heitzalexis/Maze/Rapport Final Projet Arduino - Douzet & Heitz.pdf

# DOUZET Camille HEITZ Alexis

# PROJET D’ARDUINO

# BB-MAZE

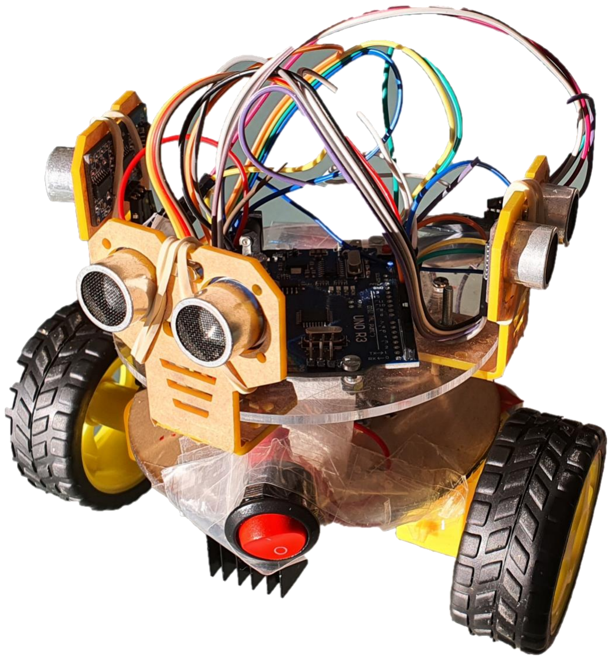
[picture p4: figure]

# Sommaire

## I. Introduction ___________________________________3

II. | Descriptif du projet _____________________________3
| II.1. L’objectif ___________________________________3
| II.2. Le cahier des charges _________________________3
III. | Description du robot et fonctionnement ____________5
| III.1. Mécanique et électronique : structure du robot ____5
| III.2. Le code_____________________________________5
IV. | Le planning ___________________________________7

## V. Synthèse _____________________________________8

| V.1. Ce que ce projet nous a apporté _________________8
| V.2. Ce que nous aurions fait différemment ___________9
VI. | Remerciements ________________________________9

## VII. Conclusions____________________________________9

| VII.1. Ce qui a été fait ______________________________9
| VII.2. Ce qu’il reste à faire___________________________10

## VIII. Bibliographies__________________________________10

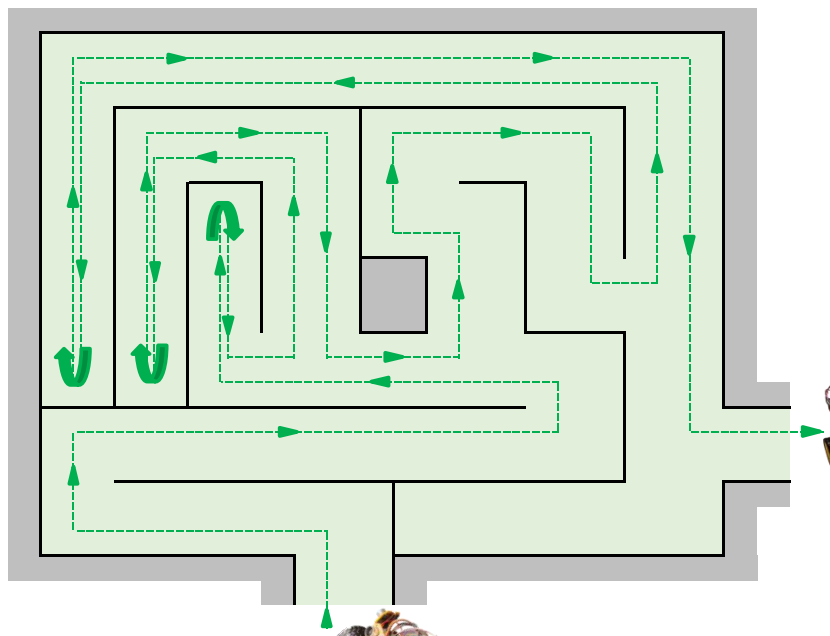
[picture p5: figure]

## I. Introduction

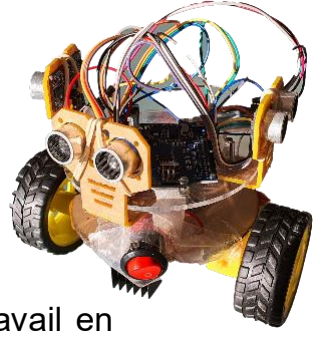
[picture p6: figure]

Le projet Arduino permet d’avoir une idée du métier d’ingénieur et du travail en entreprise. L’objectif est de nous faire travailler en équipe, sur un problème réel, afin de nous familiariser avec la méthodologie projet (Cahier des charges, comptesrendus de réunion, suivi de planning, etc …).

Nous avons appris à gérer les imprévus. Le projet a été réalisé avec un budget limité et nous a permis d’utiliser les connaissances acquises en cours, comme par exemple, l’utilisation des moteurs ou du module Bluetooth.

II. | Descriptif du projet II.1. L’objectif
| L’objectif de ce projet est de concevoir un robot motorisé, nommé BB-MAZE, fonctionnant avec la carte Arduino. BB-MAZE doit arriver à sortir d’un labyrinthe à l’aide de capteurs et d’une motorisation directionnelle. Nous partons ici du principe que les labyrinthes utilisés dans ce projet, sont définis par des murs tous reliés entre eux (C’est-à-dire connexes) et que l’on peut se rendre à n’importe quel point de ce mur, sans faire de saut. BB-MAZE est ainsi capable de se rendre à la sortie, où qu’elle soit dans le labyrinthe, en suivant, par exemple, systématiquement le mur de gauche.
| II.2 Le cahier des charges
1. Equipe projet :
| • DOUZET Camille • HEITZ Alexis
2. Environnement :
| Ce projet est réalisé dans le cadre du cours d’électronique de Peip2 de Polytech Sophia.
3. Contraintes :
| • La taille de BB-MAZE doit correspondre aux exigences vues en cours : Trop grand, il sera difficile à manipuler, encore plus dans un labyrinthe. Notamment pour réaliser les demi-tours. • Le labyrinthe comporte un point de départ et un point d’arrivée distincts. La taille des couloirs du labyrinthe doit être sensiblement supérieure à celle du robot. • BB-MAZE doit réussir à se déplacer sans percuter les obstacles. Et il pourra se trouver dans une impasse. BB-MAZE va rencontrer différentes situations qu’il devra analyser en ayant simplement les distances autour de lui. Une impasse est analysée ainsi : je n’ai pas de place, ni à gauche, ni à droite, ni devant. Donc je dois faire demi-tour. • Le robot doit avoir une connexion radiofréquence : Dans notre projet nous avons choisi le Bluetooth.

Commentaire de fin de projet : BB-MAZE devant être autonome, nous ne pouvions pas le contrôler par Bluetooth. Nous avons donc décidé d’utiliser cette connexion afin de nous indiquer ce que le robot analyse.

4. Description du robot :
- BB-MAZE est constitué d’une plaque de plexiglas découpée en forme de disque avec deux roues motrices, et une autre roue folle afin de faciliter ses déplacements dans le labyrinthe. Sa forme ronde permettra d’éviter de s’accrocher sur les murs.
- Les composants électroniques sont directement montés sur la plaque de plexiglas.
- Le robot doit se repérer dans le labyrinthe : Pour cela, il est équipé de 3 modules Sonar HC-SR04 qui donneront la distance à son environnement.
- Les fonctionnalités Bluetooth permettent de rendre compte des actions réalisées par le robot en envoyant une liste de petites phrases (“J’avance”, “Je tourne à gauche”, ...) au fur et à mesure de sa progression.
- Commentaire de fin de projet : Nous avons rajouté une pile 9 V (Voir chapitre III.1.)
5. Caractéristiques :
5.1. Caractéristiques générales :
- La taille de BB-MAZE doit être inférieure à 25 cm².
- Ses mouvements de rotation et de translation sont assurés par deux roues motrices. Pour diriger le robot, on fait tourner les deux roues avec des vitesses de rotation différentes. Pour un demi-tour nous inversons simplement le sens d’une des deux roues.
5.2. Caractéristiques générales :
- Il y a un bouton « Marche / arrêt » pour ne pas être dépendant du Bluetooth.

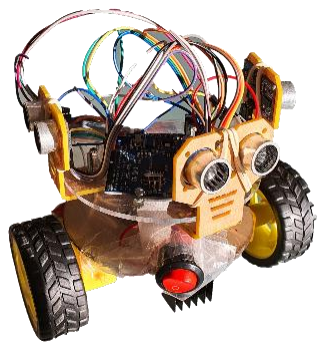
[picture p7: figure]

5.3. Informatique :
- La communication entre BB-MAZE et le téléphone se fait par Bluetooth. Nous utilisons l’application « Bluetooth Electronics » et un téléphone Android qui dispose de cette application.
- La programmation pour la recherche de la sortie du labyrinthe et pour la commande de la motorisation se font avec le logiciel Arduino.
5.4. Electronique :
- Une carte Arduino UNO comme celle utilisée dans les dernières séances avec le robot.
- 3 modules Sonar HC-SR04, pour la mesure de la position du robot dans l’espace (Ici appliqué au labyrinthe).
- Une commande de la motorisation et de la direction des roues.

5.5. Tests de validation :
- La validation se fait si BB-MAZE arrive à sortir du labyrinthe avec succès à plusieurs reprises sans percuter les murs.
Commentaire de fin de projet : Cette validation a été compliquée, car la fonction « Avancer tout droit » rencontrait des difficultés. La motorisation était trop faible, et les défauts du sol bloquaient très souvent les roues.
7. Coûts :

L’université définie le budget pour la réalisation de ce projet. Nous utilisons des composants peu coûteux. Ils pourront être réutilisés pour mener à bien d’autres futurs projets.

8. Délais :

Le planning du projet est défini séparément sur un Gantt

- Définition du projet : Fin Novembre 2019.
- 1ère phase de développement : Décembre 2019 à mi-Janvier 2020.
- Un premier oral de présentation : Mi-Janvier 2020.
- Fin du développement : Mi-Janvier 2020 à Mi-Mars 2020.
- Un dernier oral de présentation en Mi-Mars 2020.

## III. Description du robot et fonctionnement III.1. Partie mécanique et électronique : structure du robot

La partie mécanique et électronique de BB-MAZE est composée de deux disques en plexiglas qui forment 3 étages.

Sur la partie la plus basse, nous avons fixé les deux moteurs avec chacun une roue motrice. On y trouve également la carte Driver Motor (L298N Double Pont) et la roue folle. Nous avons eu beaucoup de problème pour fiabiliser le fonctionnement de cette motorisation qui s’est avérée trop faible, compte-tenu des imperfections du sol : Les roues se sont régulièrement bloquées.

A l’étage intermédiaire, se trouve l’alimentation (4 piles de 1,5 volts) et l’interrupteur de « Marche / arrêt ». Nous avons ajouté en cours de projet une pile 9 volts, afin de gérer les sauts de tensions des composants électroniques de BB-MAZE.

L’étage supérieur est occupé par la carte Arduino Uno, les trois capteurs de distance (Sonar HC-SR04) ainsi que le module Bluetooth (HC-05).

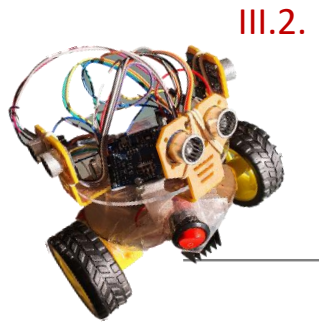
[picture p8: figure]

## III.2. Le code

Nous vous avons précédemment montré ce que notre robot doit faire. Nous allons maintenant expliciter un peu plus précisément comment nous avons programmé BB-MAZE afin de lui permettre de réagir face à toutes les situations qu’il pourrait rencontrer.

Nous avons commencé par implémenter la fonction « Tout Droit ». Comme son nom l’indique, elle indique la même vitesse aux deux roues motrices lorsqu’il y a de la place devant et sur les côtés. Ensuite nous avons ajouté les fonctionnalités « Rectifier à gauche » et « Rectifier à droite », si BB-MAZE se trouve trop près d’une paroi. Les difficultés rencontrées avec la motorisation pour cette fonction nous ont fait tester plusieurs scenarii de commande des roues. A la fin nous avons opté pour une avance par à-coup.

Enfin, nous avons codé « Tourner à droite », « Tourner à gauche » et « Faire demi-tour ». Ces fonctions s’activent lorsqu’il y a un obstacle devant BB-MAZE, et en fonction de la proximité d’une paroi. Nous avons priorisé « Tourner à gauche ». C’est-à-dire que lorsque notre robot se retrouve dans un endroit où il peut tourner à gauche où à droite, il va choisir « Tourner à gauche ». Ainsi il analyse en premier la distance à gauche et s’il peut, il tourne. Pour le demi-tour cela s’effectue quand le robot n’a de la place ni à gauche, ni à droite. Il est alors bloqué et se retourne. Voici le logigramme de notre algorithme :

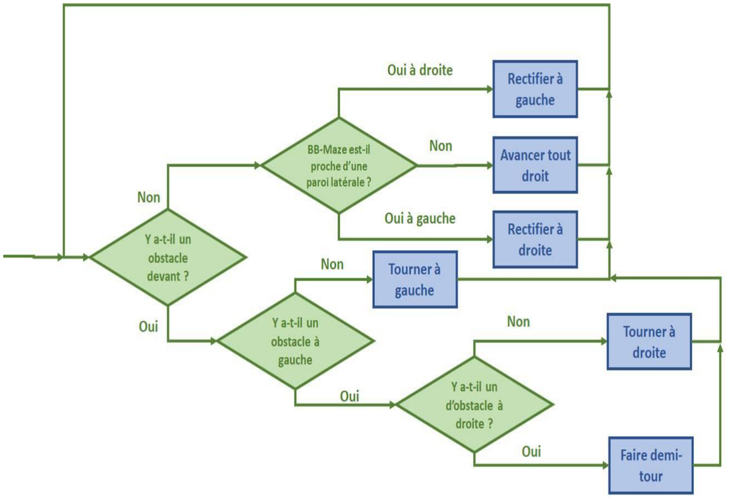
[picture p9: figure]

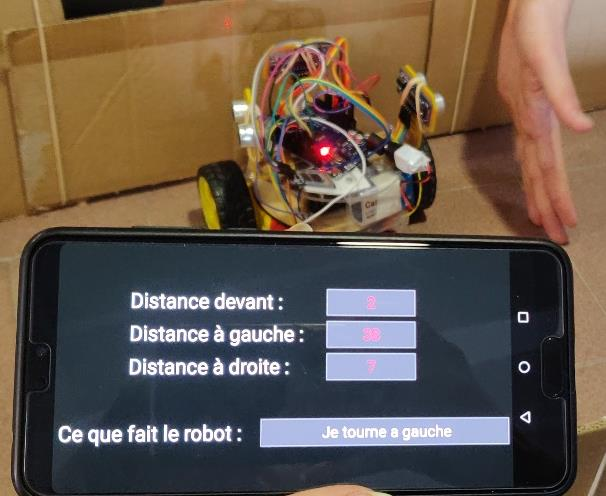
[picture p10: figure]

## IV. Le planning

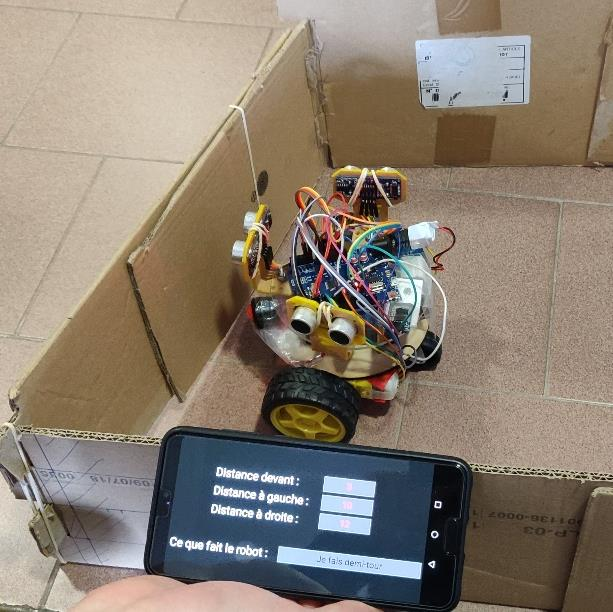
[picture p11: figure]

Lors d’un projet en entreprise, l’équipe projet établit un plan de ce qu’ils comptent faire, à l’aide d’un diagramme de Gantt. Elle essaye de prévoir les différentes étapes de ce plan avec sa durée. Cependant à la différence d’un « vrai projet », nous ne l’avons pas mis à jour en temps réel. Le Gantt initial était assez éloigné de ce que nous avons fait réellement.

Diagramme de Gantt Initial :

N° | Tâche | Qui | Durée | 4 5 6 7 8 11 12 13 14 15 18 19 20 21 22 25 26 27 28 29 2 3 4 5 6 9 10 11 12 13 16 17 18 19 20 23 24 25 26 27 30 31 1 2 3 6 7 8 9 10 13 14 15 16 17 20 21 22 23 24 27 28 29 30 31 3 4 5 6 7 10 11 12 13 14 17 18 19 20 21 24 25 26 27 28 2 3 4 5 6 9 10 11 12 13 16 17 | 18 19 20
1. Lancement du Projet | | | | ¨
1.1. | Formation du binôme | | | ¨ ¨
1.2. | Choix du sujet | Camille et Alexis | 1 j
1.3. | Recherche sur l'état de l'art | Camille | 2 j
1.4. | Ecriture du Cahier des Charges | Alexis | 2 j
1.4. | Remise du Cahier des charges | Alexis | 1j
2. Avant Projet
2.1. | Maquette du robot | Camille | 10 j
2.2. | Maquette du labyrinthe | Alexis | 5 j
2.3. | Définition du circuit électrique | Alexis | 3 j
2.4. | Définition de la structure du programme | Camille et Alexis | 5 j
3. Projet
3.1. Réalisation du robot
3.1.1. | Structure | Camille | 10 j
3.1.2. | Motorisation | Alexis | 6 j
3.1.3. | Capteurs | Alexis | 2 j
3.1.4. | Montage | Camille et Alexis | 3 j
3.2. | Réalisation du labyrinthe | Camille | 5 j
3.3. Réalisation du circuit électrique
3.3;1. | Capteurs | Alexis | 5 j
3.3.2. | Carte Arduino | Alexis | 5 j
3.3.3. | Carte électronique | Alexis | 5 j
3.3.4. | Câblage | Alexis | 5 j
3.3.5. | Tests fonctionnels | Camille | 5 j
3.4. Réalisation du programme
3.4.1. | Animation de la motorisation | Camille | 5 j
3.4.2. | Fonctions de repérage dans l'espace | Camille | 5 j
3.4.3. | Décisions de déplacement | Camille | 10 j
3.4.4. | Tests fonctionnels | Alexis | 5 j

### 4. Tests

4.1. | Test sur Labyrinthe réel | Camille et Alexis | 5 j
5. Présentation du stage | | | | ¨ ¨
5.1. | Réalisation de la video | Camille et Alexis | 4 j
5.2. | Réalisation du rapport word | Camille | 4 j
5.3. | Réalisation du powerpoint | Camille et Alexis | 6 j
5.4. | Présentation orale au jury | Camille et Alexis | 1 j | ¨
5.5. | Remise du rapport | Camille et Alexis | 1 j
5.6. | Présentation finale au jury | Camille et Alexis | 1J

## GANTT

2019 | 2020
Nom du Projet : Labyrinthe Camille et Alexis | Novembre | Décembre | Janvier | Février | Mars

Diagramme de Gantt final :

En comparant ces deux diagrammes nous remarquons que la première phase du projet, qui est constituée du choix des composants, de la vérification des composants et de la construction de la maquette, est d’une durée assez proche du Gantt initial : Environ 20 jours.

En cours de projet, les rôles se sont inversés entre nous car nous ne savions pas à l’avance qui serait le plus à l’aise pour quelle tâche.

Ensuite nous avons construit BB-MAZE et fait le code qui lui permet de se déplacer. Ici nous avons surestimé le temps de construction du robot et sous-estimé le temps que nous a pris le code pour être « fonctionnel ».

La construction du labyrinthe a été plus longue que prévue, mais celà n’a pas eu d’impact sur le projet, car cette tâche se déroulait en parallèle avec le restant du projet.

Finalement les tests ont été beaucoup plus long que prévu. Cela s’explique par le fait que notre robot a eu des problèmes de mise au point et que nous avons essayé jusqu’au dernier moment de régler ces problèmes.

## V. Synthèse : V.1. Ce que ce projet nous a apporté

Sur le plan personnel, ce projet nous a appris à travailler en équipe. En effet, cela nous a donné le sens des responsabilités car le projet n’est pas individuel. Cela nous a permis de nous rendre plus autonome pour résoudre nos problèmes et tester par nous-mêmes les solutions. Cela nous a poussé à être créatif pour trouver des nouvelles idées, notamment en faisant des recherches sur Internet.
Sur le plan professionnel, le projet nous a permis de nous rendre compte en quoi consiste le métier d’ingénieur et l’investissement que cela signifie. Réaliser un tel projet permet de mettre un pied dans le monde du travail. Et permet d’en comprendre les contraintes et les difficultés.
2. | Choix et vérification des | Camille + Alexis | 6 j
3. | Réalisation de la maquette | Camille + Alexis | 13 j
4. | Construction du robot | Camille | 9 j
5. | Codage | Alexis | 34 j
6. | Optimisation et affinage du code | Alexis | 13 j
7. | Construction du labyrinthe | Camille | 10 j
8. | Tests | Camille + Alexis | 11 j
9. | Préparation de la présentation | Camille + Alexis | 7 j
Nom du Projet : Labyrinthe Camille et Alexis | GANTT
2019 | 2020
Novembre | Décembre | Janvier | Février | Mars
N° | Tâche | Qui | Durée | 4 5 6 | 7 8 11 12 13 14 15 18 19 20 21 22 25 26 27 28 29 2 3 4 5 6 | 9 10 11 | 12 13 16 | 17 18 19 | 20 23 24 | 25 26 27 | 30 31 1 | 2 3 6 7 8 9 10 13 14 15 16 17 20 21 22 23 24 27 28 29 30 31 | 3 4 5 | 6 7 10 | 11 12 13 | 14 17 18 | 19 20 21 | 24 25 26 | 27 28 2 | 3 4 5 6 9 10 11 12 13 16 17 18 19 20
1. | Lancement du Projet | Camille + Alexis | 25 j

Nous avons aussi compris que le déroulement d’un projet n’est jamais linéaire. Il faut parfois revenir en arrière ou prendre du recul sur la situation. Il a fallu faire les bons choix ou encore faire des compromis (Comme la longueur du labyrinthe par exemple). Car il y a toujours une différence entre nos attentes et la réalité.
Nous avons appris à utiliser des outils comme le diagramme de Gantt, Github etc….
Sur le plan scolaire, nous avons mis en œuvre nos connaissances du premier semestre en cours d’électronique et en Arduino. Nous avons appris à utiliser du matériel en le développant pour une autre utilité. Ce projet a ainsi rendu concret tous les exercices fait en classe, ce qui était très motivant.

En bref, la réalisation de ce projet a été en tout point positif à nos yeux et a permis à Camille d’apprécier l’électronique comme potentielle spécialisation.

## V.2. Ce que nous aurions fait différemment

Un projet ne se déroule jamais à la perfection. Il y a donc évidemment des points que nous aurions pu améliorer. Par exemple, prendre les décisions plus rapidement. Ne pas s’entêter dans une direction et essayer de prendre du recul sur la situation pour trouver des solutions plus innovantes, comme pour notre problème « Avancer tout droit ».

Nous aurions pu utiliser des composants plus robustes, qui aurait facilité le fonctionnement et diminué la phase de tests.

## VI. Remerciements

Nous remercions vivement Monsieur Masson pour l’aide qu’il nous a apporté tout au long du projet et la qualité des cours en préparation.

Nous remercions également Nassim Abderrahmane pour les conseils judicieux qu’il nous a donné. Sans lui, nous aurions régulièrement été bloqué dans la résolution des problèmes.

## VII. Conclusion VII.1. Ce qui a été fait

Nous avons réalisé un robot, nommé BB-MAZE, qui sait avancer tout droit en corrigeant sa trajectoire, tourner à droite, tourner à gauche et faire demi-tour.

Il a été conçu pour sortir de manière autonome d’un labyrinthe et rendre compte à un téléphone portable par des messages Bluetooth.

Le robot est fonctionnel, sauf pour la fonction « Avancer tout droit » qui est perturbée par le manque de puissance sur les deux roues motrices. BB-Maze ne réussissait donc pas systématiquement à sortie du labyrinthe.

Nous avons suivi la méthodologie projet (Cahier des charges, Gantt, comptesrendus de réunion, …) et nous avons appris à travailler en équipe.

## VII.2. Ce qu’il reste à faire

Il reste à fiabiliser la fonction « Avancer tout droit », soit en remplaçant la motorisation, soit en remplaçant le système de détection par un équipement plus robuste.

Une autre solution pourrait être de fiabiliser la fonction « Rectifier » par une commande PID (Proportionnelle / Intégrale / Dérivé).

## VIII. Annexes, bibliographies

- https://create.arduino.cc/projecthub/MakerRobotics/arduino-robot-poliardomaze-solver-b41341 (https://create.arduino.cc/projecthub/MakerRobotics/arduino-robot-poliardo-maze-solver-b41341)
- https://www.instructables.com/id/Line-Follower-Robot-PID-Control-Android-Setup/ (https://www.instructables.com/id/Line-Follower-Robot-PID-Control-Android-Setup/)
- https://www.robotshop.com/community/robots/show/amaze
- https://www.researchgate.net/figure/Figure-53-Physical-Configuration-TOP_fig10_316664613 (https://www.researchgate.net/figure/Figure-53-Physical-Configuration-TOP_fig10_316664613)
- https://www.researchgate.net/publication/316664613_AUTONOMOUS_MAZE_SOLVING_ROBOT (https://www.researchgate.net/publication/316664613_AUTONOMOUS_MAZE_SOLVING_ROBOT)
- http://www.ferdinandpiette.com/blog/2012/04/asservissement-en-vitessedun-moteur-avec-arduino/ (http://www.ferdinandpiette.com/blog/2012/04/asservissement-en-vitesse-dun-moteur-avec-arduino/)
