heitzalexis/Maze/Rapports séance/Vidéos séance/PhotoBluetooth.pdf

DOUZET Camille Groupe 2

Photographies des différentes situations du fonctionnement du Bluetooth

Situation Rectifier à gauche :

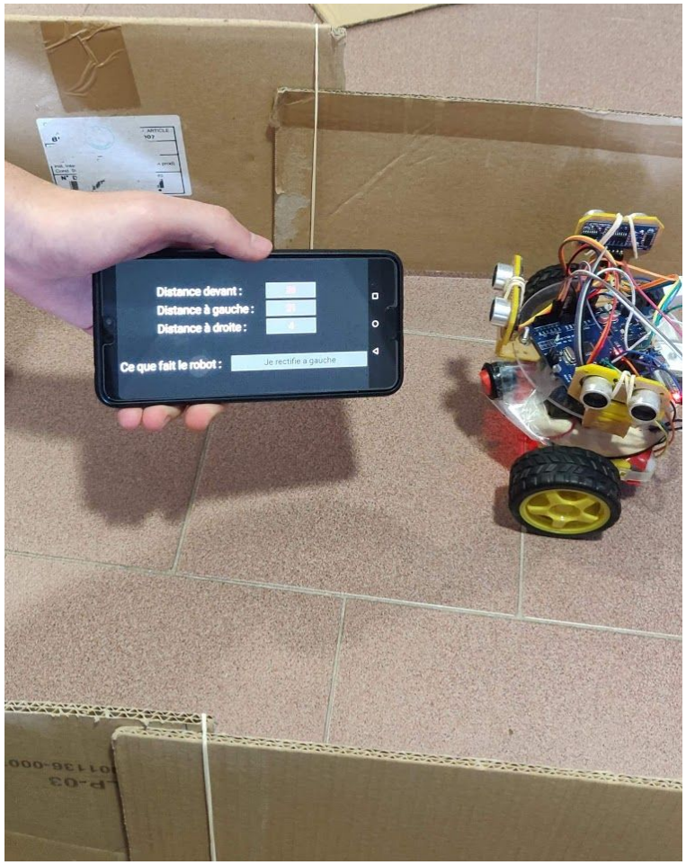
[picture p31: figure]

Situation Rectifier à droite :

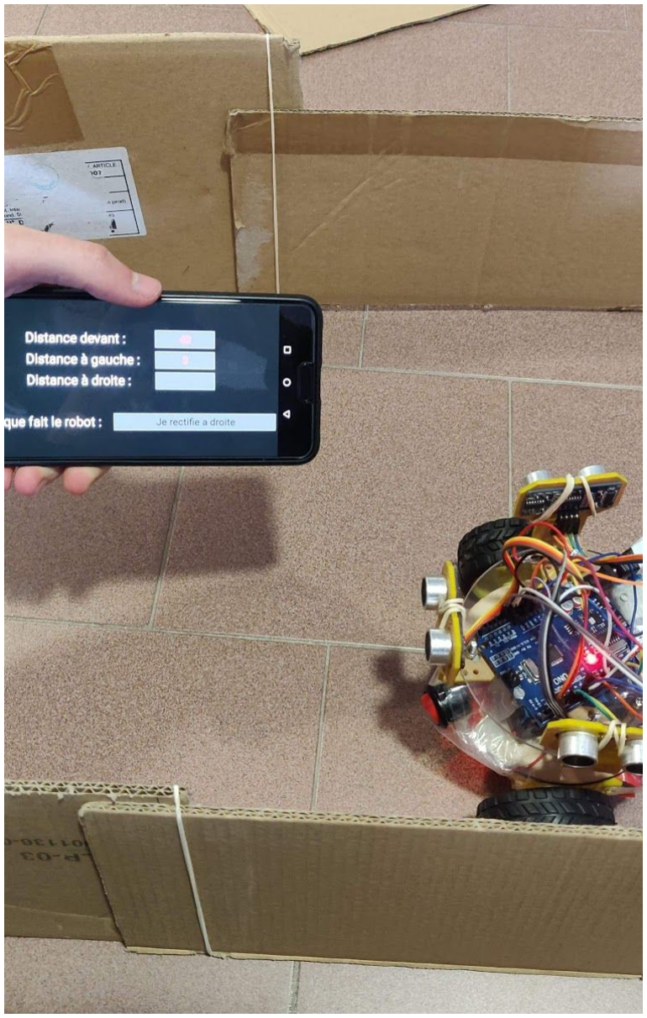
[picture p32: figure]

Situation Tourner à gauche :

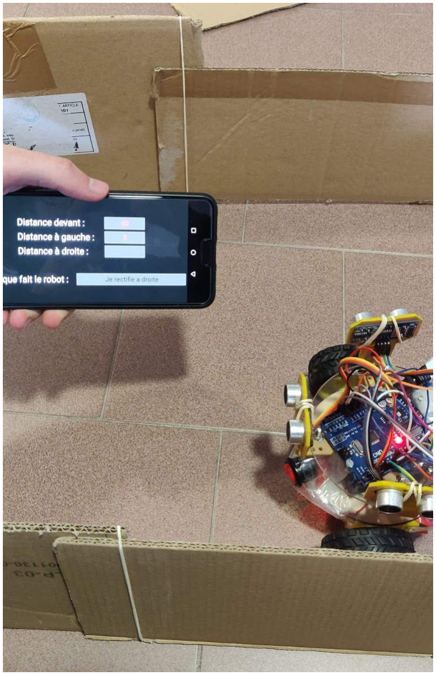
[picture p33: figure]
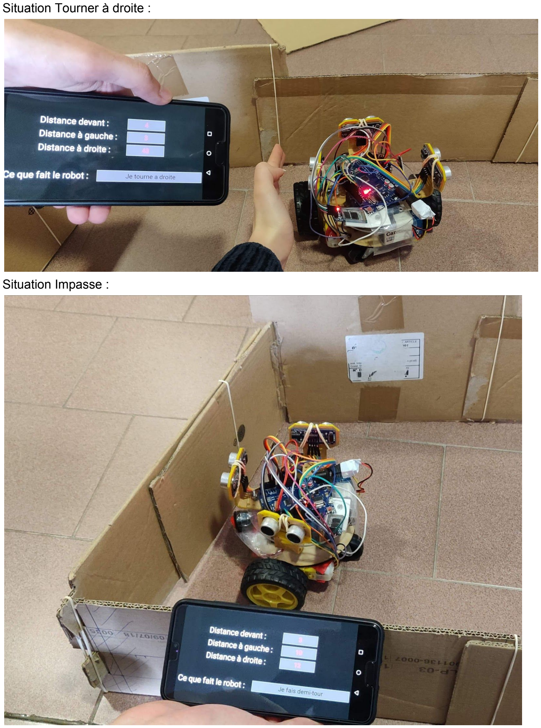
[picture p34: page 4]

Situation Tourner à droite :

Situation Impasse :
