heitzalexis/Maze/(commit log)

2019-12-17 Ajout du rapport de séance 2 Camille DOUZET GR2
2020-02-10 Création dossier vidéo utile pour les rapports
2020-02-26 Rapport de ce que j'ai fait pendant les vacances
2020-03-09 Vidéo de présentation
